LegendTurtle/doc-etz-reg/Фото/Вид сверху.jpg

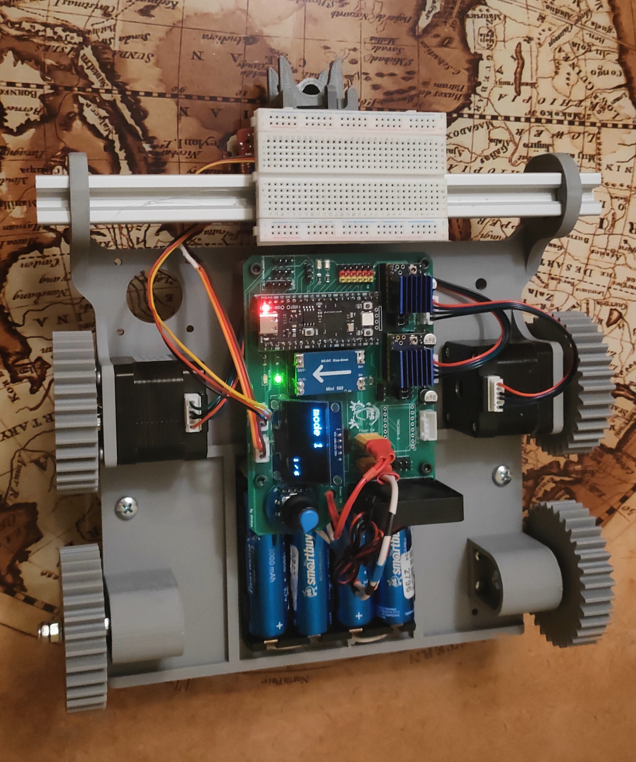
Фото/Вид сверху.jpg
