LegendTurtle/doc-etz-reg/Фото/Вид спереди.jpg

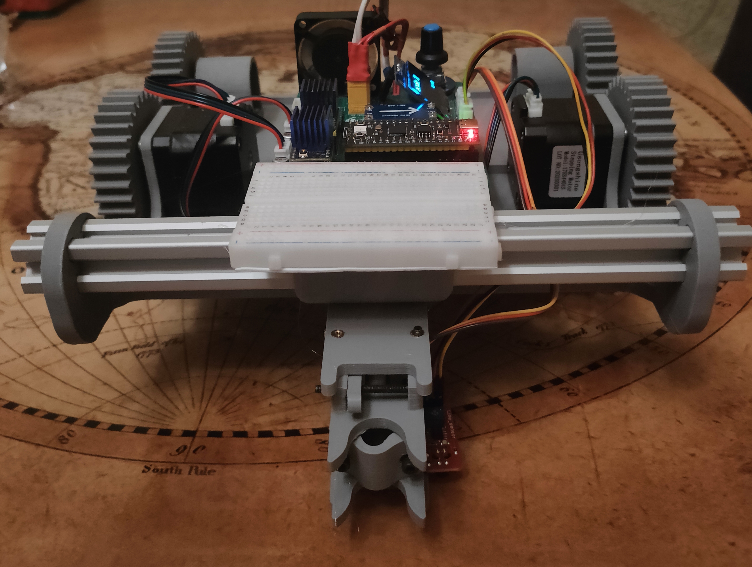
Фото/Вид спереди.jpg
