LegendTurtle/doc-etz-reg/Фото/Вид сбоку.jpg

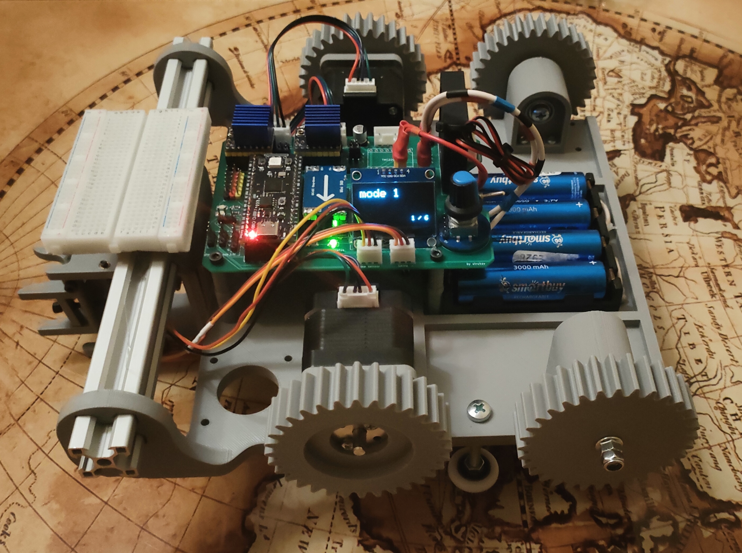
Фото/Вид сбоку.jpg
