LegendTurtle/doc-etz-reg/3D-модели/up-part-z.step

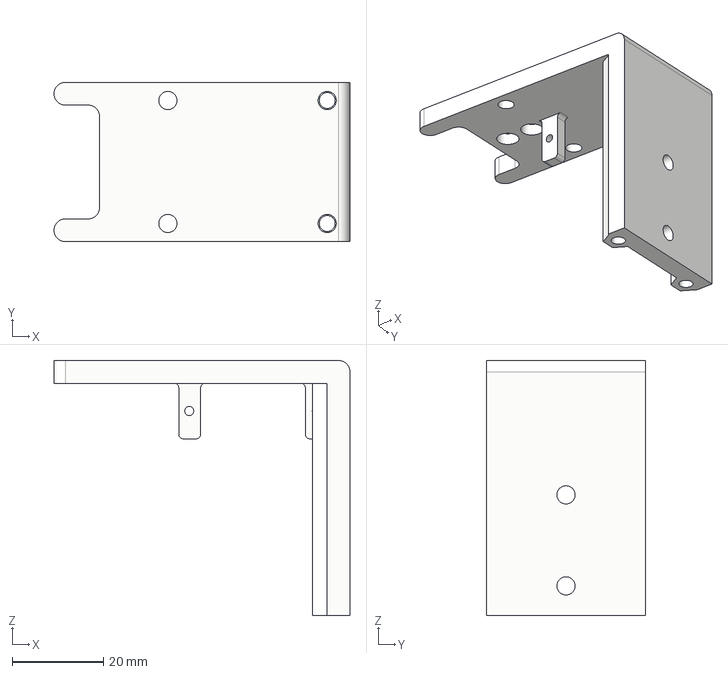
[picture p4: CAD file, 2026-01-12]
3D-модели/up-part-z.step
65.0 x 35.0 x 56.0 mm
