LegendTurtle/doc-etz-reg/3D-модели/marker-fixator-1.step

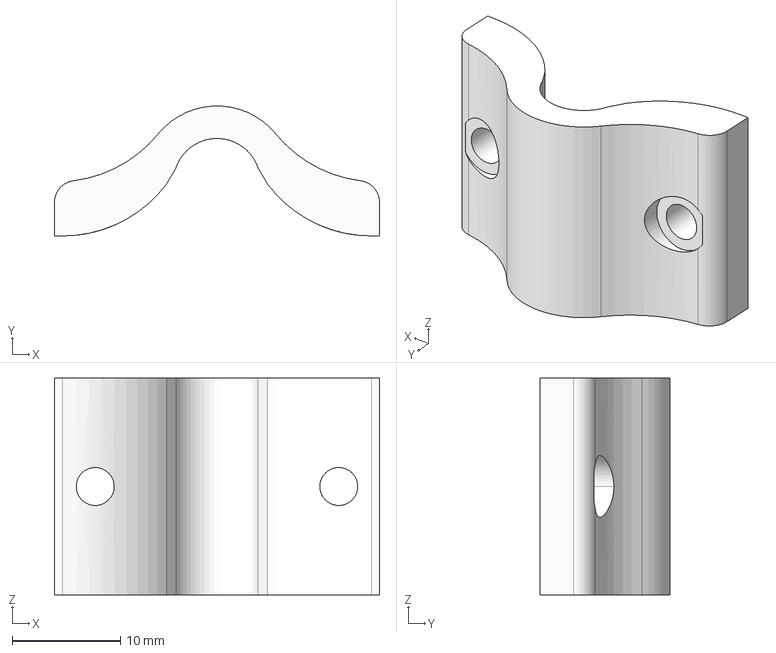
[picture p5: CAD file, 2026-01-12]
3D-модели/marker-fixator-1.step
30.0 x 12.0 x 20.0 mm
