LegendTurtle/doc-etz-reg/3D-модели/servo-arm.step

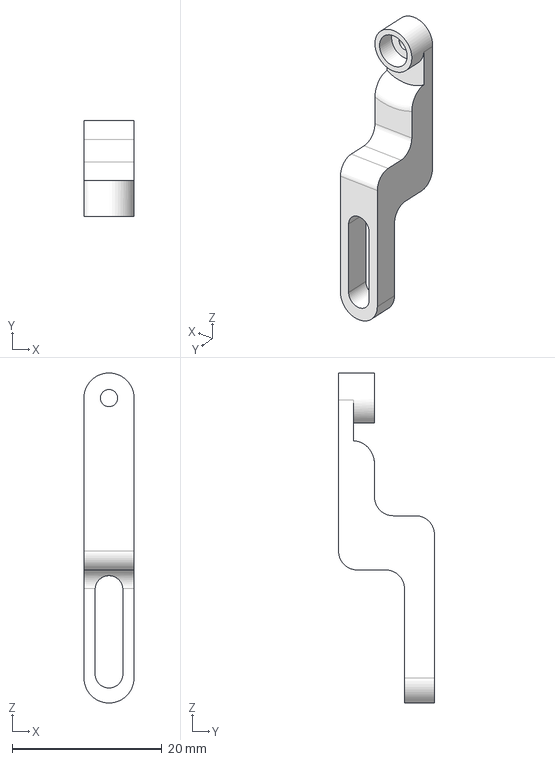
[picture p6: CAD file, 2026-01-12]
3D-модели/servo-arm.step
6.70 x 12.8 x 44.1 mm
