LegendTurtle/doc-etz-reg/3D-модели/down-part-z.step

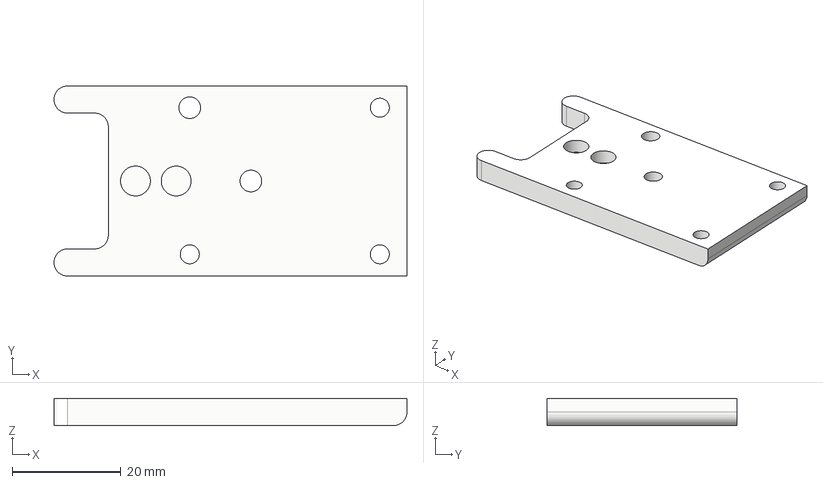
[picture p7: CAD file, 2026-01-12]
3D-модели/down-part-z.step
65.0 x 35.0 x 5.00 mm
