LegendTurtle/doc-etz-reg/3D-модели/stoyka.step

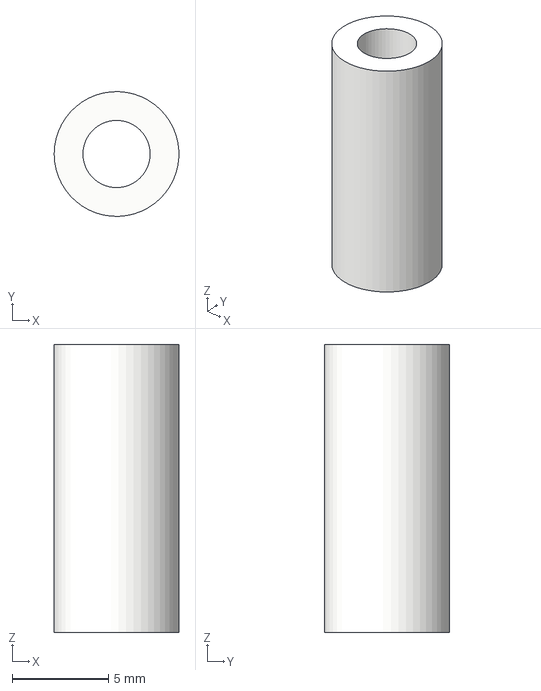
[picture p8: CAD file, 2026-01-12]
3D-модели/stoyka.step
6.49 x 6.50 x 15.0 mm
