LegendTurtle/doc-etz-reg/3D-модели/z-axis-rigid-fixator.step

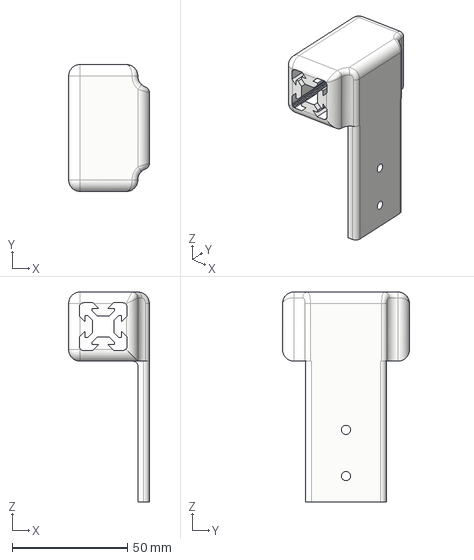
[picture p9: CAD file, 2026-01-12]
3D-модели/z-axis-rigid-fixator.step
35.0 x 55.0 x 91.0 mm
