LegendTurtle/doc-etz-reg/3D-модели/base.step

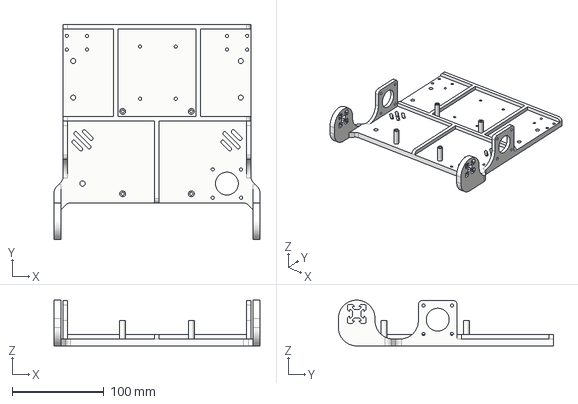
[picture p10: CAD file, 2026-01-12]
3D-модели/base.step
225.0 x 235.0 x 50.0 mm
