LegendTurtle/doc-etz-reg/3D-модели/parasit_gear_fixator.step

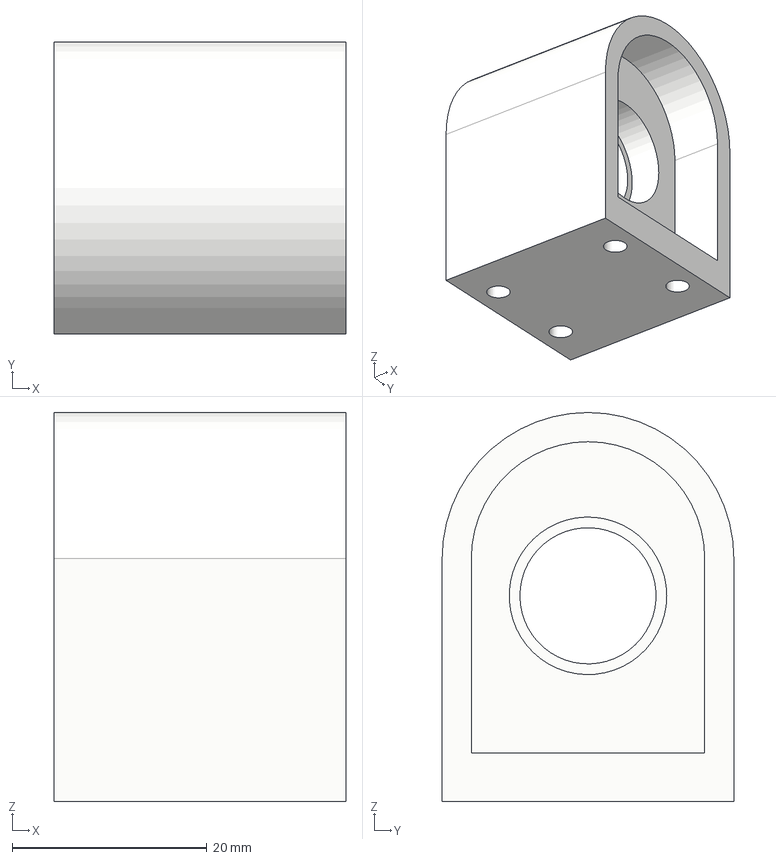
[picture p11: CAD file, 2026-01-12]
3D-модели/parasit_gear_fixator.step
30.0 x 30.0 x 40.0 mm
