LegendTurtle/doc-etz-reg/3D-модели/marker-fixator-2.step

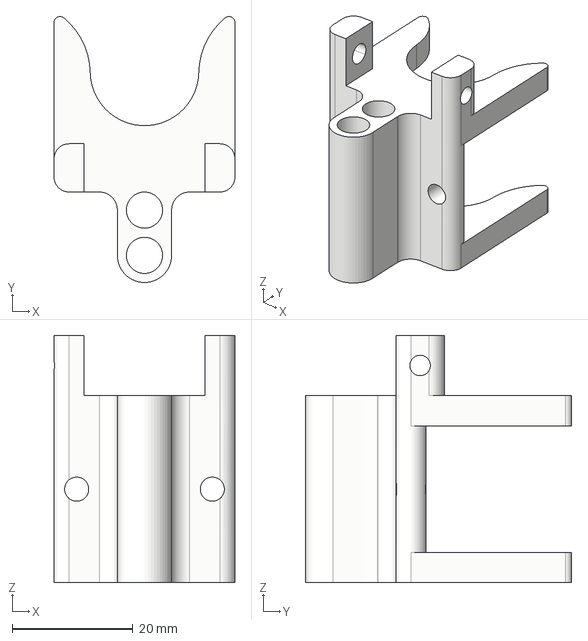
[picture p12: CAD file, 2026-01-12]
3D-модели/marker-fixator-2.step
30.0 x 44.1 x 41.0 mm
