LegendTurtle/doc-etz-reg/Схемы/Принципиальная схема.pdf

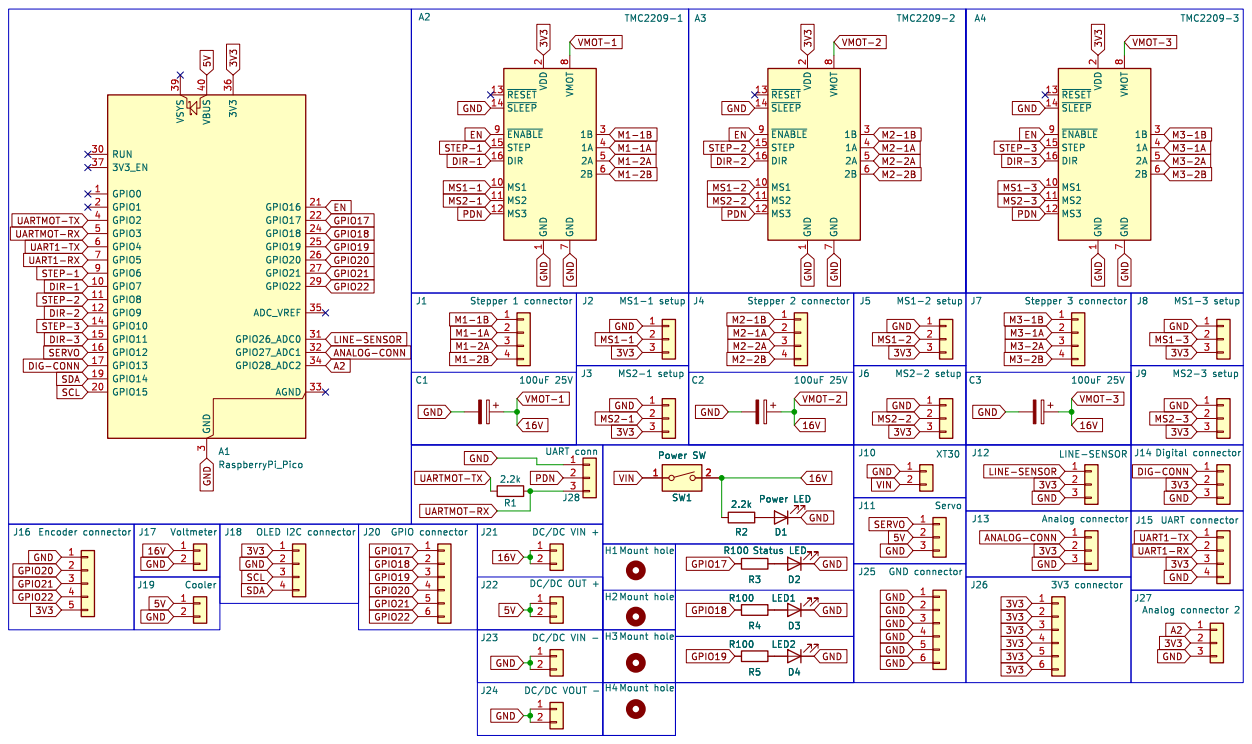
[picture p13: page 1]

J15 UART connector H4 Mount hole H3 Mount hole
