LegendTurtle/doc-etz-reg/Схемы/Структурная схема.pdf

# светодиоды Логика

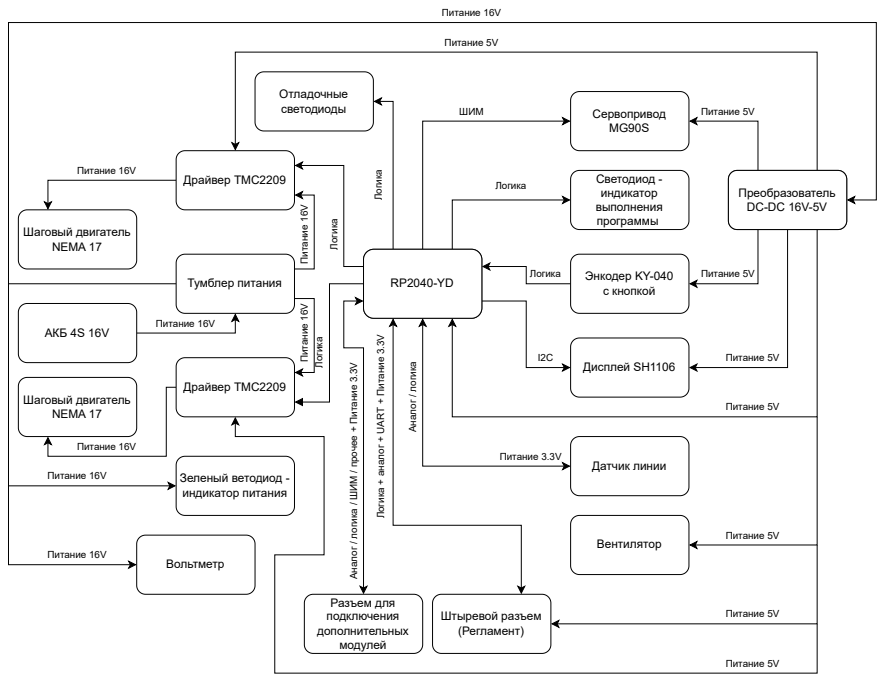
[picture p14: page 1]
Логика; Дисплей SH1106; Светодиод - индикатор выполнения программы; Преобразователь; Сервопривод MG90S; Тумблер питания; Шаговый двигатель NEMA 17; Драйвер TMC2209; Питание 16V Питание 16V; Зеленый ветодиод - индикатор питания; Питание 16V; АКБ 4S 16V; Питание 5V; ШИМ; Энкодер KY-040; с кнопкой; Преобразователь DC-DC 16V-5V; Датчик линии; Вентилятор; Вольтметр; Отладочные; Штыревой разъем (Регламент); Разъем для подключения дополнительных; Аналог / логика; Питание 3.3V

модулейЛогика + аналог + UART + Питание 3.3V

Аналог / логика / ШИМ / прочее + Питание 3.3V
