LegendTurtle/doc-etz-reg/Плата/etz-2025.kicad_pcb

## KiCad design Плата/etz-2025.kicad_pcb (2026-01-12)

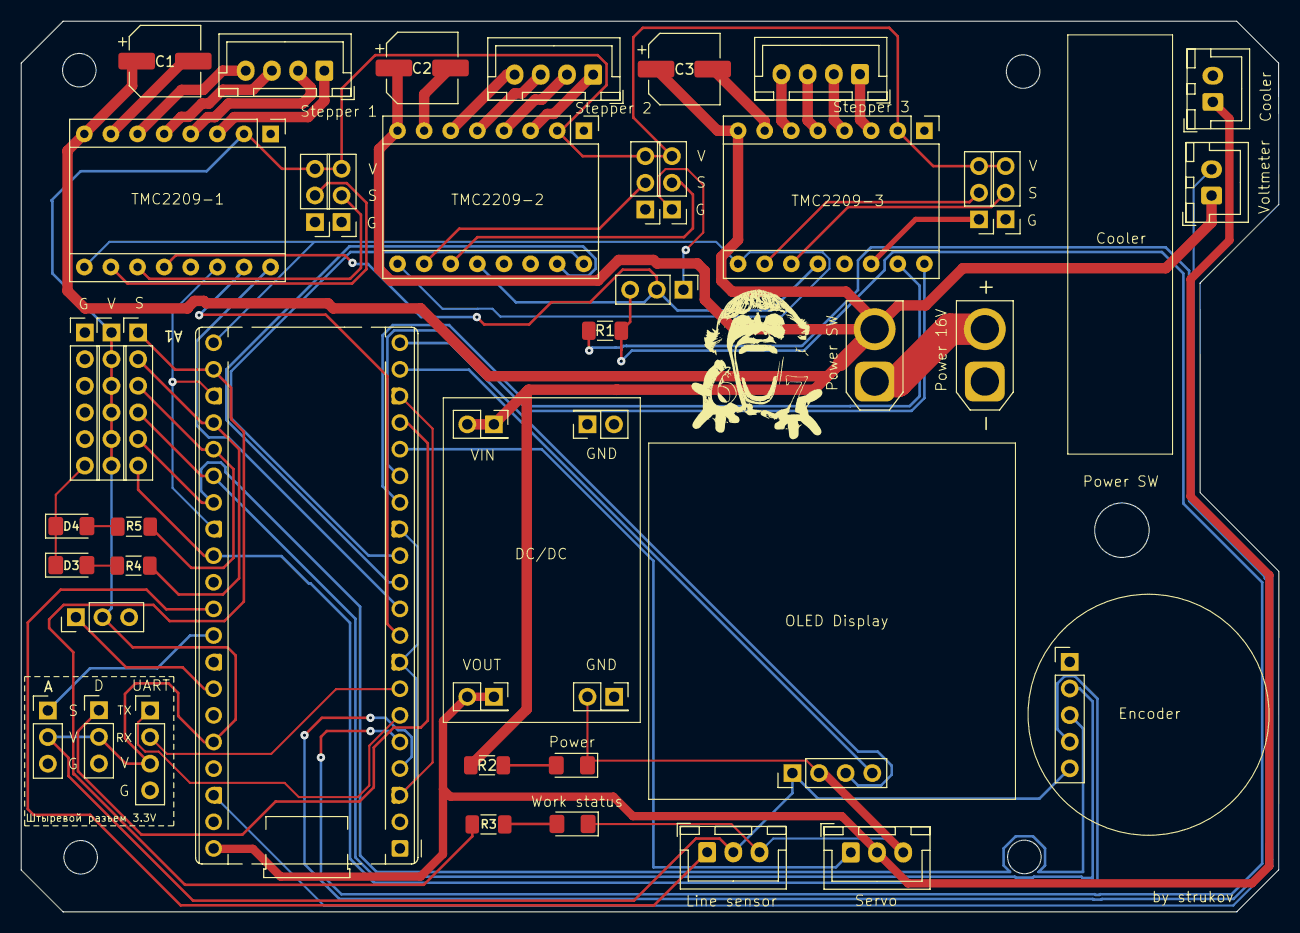
[picture p15: board etz-2025.kicad_pcb from above]

Board: 2 copper layers, 120.0 x 85.0 mm, 49 parts (0 on the bottom side), 52 nets.

Parts:
A1: RaspberryPi_Pico; RaspberryPi_Pico_Common_THT
A2: TMC2209-1; Pololu_Breakout-16_15.2x20.3mm
A3: TMC2209-2; Pololu_Breakout-16_15.2x20.3mm
A4: TMC2209-3; Pololu_Breakout-16_15.2x20.3mm
C1, C2, C3: 100uF 25V; CP_Elec_6.3x7.7
D1: Power LED; LED_1206_3216Metric_Pad1.42x1.75mm_HandSolder
D2: Status LED; LED_1206_3216Metric_Pad1.42x1.75mm_HandSolder
D3: LED1; LED_1206_3216Metric_Pad1.42x1.75mm_HandSolder
D4: LED2; LED_1206_3216Metric_Pad1.42x1.75mm_HandSolder
H1, H2, H3, H4: Mount hole; MountingHole_3.2mm_M3
J1: Stepper 1 connector; JST_XH_B4B-XH-A_1x04_P2.50mm_Vertical
J2: MS1-1 setup; PinHeader_1x03_P2.54mm_Vertical
J3: MS2-1 setup; PinHeader_1x03_P2.54mm_Vertical
J4: Stepper 2 connector; JST_XH_B4B-XH-A_1x04_P2.50mm_Vertical
J5: MS1-2 setup; PinHeader_1x03_P2.54mm_Vertical
J6: MS2-2 setup; PinHeader_1x03_P2.54mm_Vertical
J7: Stepper 3 connector; JST_XH_B4B-XH-A_1x04_P2.50mm_Vertical
J8: MS1-3 setup; PinHeader_1x03_P2.54mm_Vertical
J9: MS2-3 setup; PinHeader_1x03_P2.54mm_Vertical
J10: XT30; AMASS_XT30U-F_1x02_P5.0mm_Vertical
J11: Servo; JST_XH_B3B-XH-A_1x03_P2.50mm_Vertical
J12: LINE-SENSOR; JST_XH_B3B-XH-A_1x03_P2.50mm_Vertical
J13: Analog connector; PinHeader_1x03_P2.54mm_Vertical
J14: Digital connector; PinHeader_1x03_P2.54mm_Vertical
J15: UART connector; PinHeader_1x04_P2.54mm_Vertical
J16: Encoder connector; PinHeader_1x05_P2.54mm_Vertical
J17: Voltmeter; JST_XH_B2B-XH-A_1x02_P2.50mm_Vertical
J18: OLED I2C connector; PinHeader_1x04_P2.54mm_Vertical
J19: Cooler; JST_XH_B2B-XH-A_1x02_P2.50mm_Vertical
J20: GPIO connector; PinHeader_1x06_P2.54mm_Vertical
J21: DC/DC VIN +; PinSocket_2x01_P2.54mm_Vertical
J22: DC/DC OUT +; PinSocket_2x01_P2.54mm_Vertical
J23: DC/DC VIN -; PinSocket_2x01_P2.54mm_Vertical
J24: DC/DC VOUT -; PinSocket_2x01_P2.54mm_Vertical
J25: GND connector; PinHeader_1x06_P2.54mm_Vertical
J26: 3V3 connector; PinHeader_1x06_P2.54mm_Vertical
J27: Analog connector 2; PinHeader_1x03_P2.54mm_Vertical
J28: UART conn; PinHeader_1x03_P2.54mm_Vertical
R1, R2: 2.2k; R_1206_3216Metric_Pad1.30x1.75mm_HandSolder
R3, R4, R5: R100; R_1206_3216Metric_Pad1.30x1.75mm_HandSolder
SW1: Power SW; AMASS_XT30U-F_1x02_P5.0mm_Vertical

Connections:
3V3: A1.36 (3V3), A2.2 (VDD), A3.2 (VDD), A4.2 (VDD), J2.3, J3.3, J5.3, J6.3, J8.3, J9.3, J12.2, J13.2, J14.2, J15.3, J16.5, J18.1, J26.1, J26.2, J26.3, J26.4, J26.5, J26.6, J27.2
5V: A1.40 (VBUS), J11.2, J19.1, J22.1, J22.2
16V: A2.8 (VMOT), A3.8 (VMOT), A4.8 (VMOT), C1.1, C2.1, C3.1, J17.1, J21.1, J21.2, R2.1, SW1.2
A2: A1.34 (GPIO28_ADC2), J27.1
ANALOG-CONN: A1.32 (GPIO27_ADC1), J13.1
DIG-CONN: A1.17 (GPIO13), J14.1
DIR-1: A1.10 (GPIO7), A2.16 (DIR)
DIR-2: A1.12 (GPIO9), A3.16 (DIR)
DIR-3: A1.15 (GPIO11), A4.16 (DIR)
EN: A1.21 (GPIO16), A2.9 (~ENABLE), A3.9 (~ENABLE), A4.9 (~ENABLE)
GND: A1.3 (GND), A1.8 (GND), A1.13 (GND), A1.18 (GND), A1.23 (GND), A1.28 (GND), A1.38 (GND), A2.1 (GND), A2.7 (GND), A2.14 (~SLEEP), A3.1 (GND), A3.7 (GND), A3.14 (~SLEEP), A4.1 (GND), A4.7 (GND), A4.14 (~SLEEP), C1.2, C2.2, C3.2, D1.1 (K), D2.1 (K), D3.1 (K), D4.1 (K), J2.1, J3.1, J5.1, J6.1, J8.1, J9.1, J10.1, J11.3, J12.3, J13.3, J14.3, J15.4, J16.1, J17.2, J18.2, J19.2, J23.1, J23.2, J24.1, J24.2, J25.1, J25.2, J25.3, J25.4, J25.5, J25.6, J27.3, J28.1
GPIO17: A1.22 (GPIO17), J20.1, R3.1
GPIO18: A1.24 (GPIO18), J20.2, R4.1
GPIO19: A1.25 (GPIO19), J20.3, R5.1
GPIO20: A1.26 (GPIO20), J16.2, J20.4
GPIO21: A1.27 (GPIO21), J16.3, J20.5
GPIO22: A1.29 (GPIO22), J16.4, J20.6
LINE-SENSOR: A1.31 (GPIO26_ADC0), J12.1
M1-1A: A2.4 (1A), J1.2
M1-1B: A2.3 (1B), J1.1
M1-2A: A2.5 (2A), J1.3
M1-2B: A2.6 (2B), J1.4
M2-1A: A3.4 (1A), J4.2
M2-1B: A3.3 (1B), J4.1
M2-2A: A3.5 (2A), J4.3
M2-2B: A3.6 (2B), J4.4
M3-1A: A4.4 (1A), J7.2
M3-1B: A4.3 (1B), J7.1
M3-2A: A4.5 (2A), J7.3
M3-2B: A4.6 (2B), J7.4
MS1-1: A2.10 (MS1), J2.2
MS1-2: A3.10 (MS1), J5.2
MS1-3: A4.10 (MS1), J8.2
MS2-1: A2.11 (MS2), J3.2
MS2-2: A3.11 (MS2), J6.2
MS2-3: A4.11 (MS2), J9.2
unnamed: D1.2 (A), R2.2
unnamed: D2.2 (A), R3.2
unnamed: D3.2 (A), R4.2
unnamed: D4.2 (A), R5.2
PDN: A2.12 (MS3), A3.12 (MS3), A4.12 (MS3), J28.2
SCL: A1.20 (GPIO15), J18.3
SDA: A1.19 (GPIO14), J18.4
SERVO: A1.16 (GPIO12), J11.1
STEP-1: A1.9 (GPIO6), A2.15 (STEP)
STEP-2: A1.11 (GPIO8), A3.15 (STEP)
STEP-3: A1.14 (GPIO10), A4.15 (STEP)
UART1-RX: A1.7 (GPIO5), J15.2
UART1-TX: A1.6 (GPIO4), J15.1
UARTMOT-RX: A1.5 (GPIO3), J28.3, R1.2
UARTMOT-TX: A1.4 (GPIO2), R1.1
VIN: J10.2, SW1.1
